evilmtv/CG3002-Dance-Dance-01/Docs/Handouts/Multi-Class Classification Tutorial with the Scikit-learn Library.pdf

# Multi‐Class Classification Tutorial with the Scikit‐learn Library

# Zhao Na

CG3002

# Overview

- Scikit‐learn is a Python library for machine learning that features various classification, regression and clustering algorithms including support vector machines, random forests, k‐means, and is designed to interoperate with the Python numerical and scientific libraries NumPy and SciPy.
- In this tutorial, you will discover how you can use Scikit‐learn to develop and evaluate SVM model for multi‐class classification problem.

# Problem Description

In this tutorial, we will use the standard machine learning dataset called the iris flowers dataset.

This dataset is well studied and is a good problem for practicing on machine learning because all of the 4 input variables are numeric and have the same scale in centimeters. Each instance describes the properties of an observed flower measurements and the output variable is specific iris species.

This is a multi
‐class classification problem, with three classes (flower species) to be predicted.

The iris flower dataset is a well
‐studied problem and a such we can expect to achieve a model accuracy in the range of 95% to 97%. This provides a good target to aim for when developing our models.

# Step‐by‐step tutorial

☐ Step 0: Data segmentation

☐ Step 1: Data pre‐processing

☐ Step 2: Model selection: choosing estimators and parameters

☐ Step 3: Evaluate the model with K‐fold cross validation

# Step 0: Data segmentation

In the iris flower dataset, there is no need to segment data. However, in your actual project data segmentation is necessary, because identifying the start and end of the actual activity from signals is important for recognizing the activity accurately.

There are several criteria to segment signal, such as:
- Time
- Abrupt change

# Step 0: Data segmentation

- In this tutorial, we give an example that how to segment signal with non‐overlap time window.

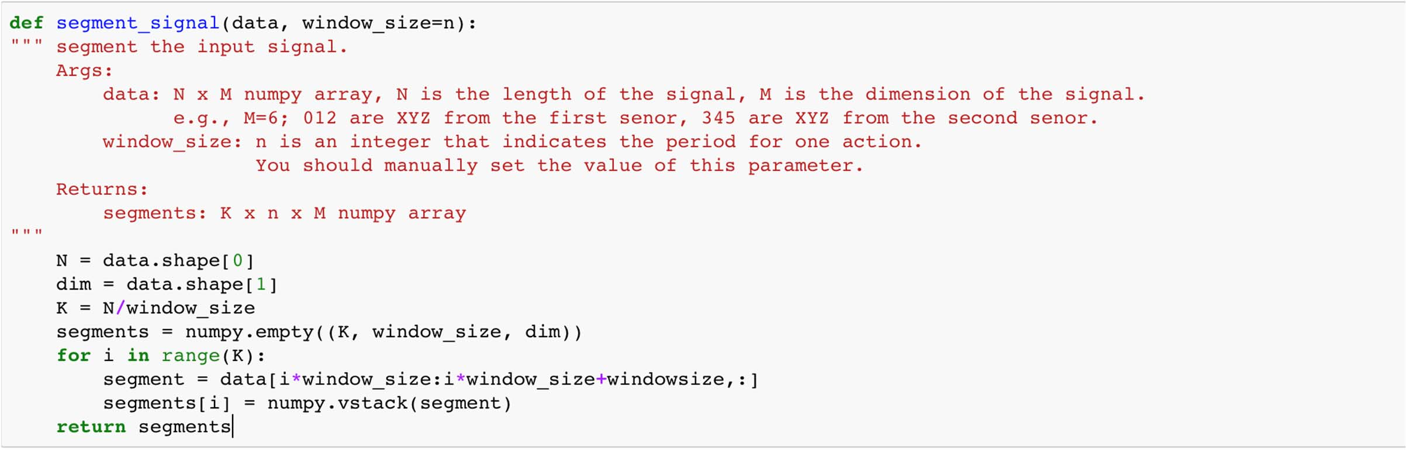
[picture p9: figure]

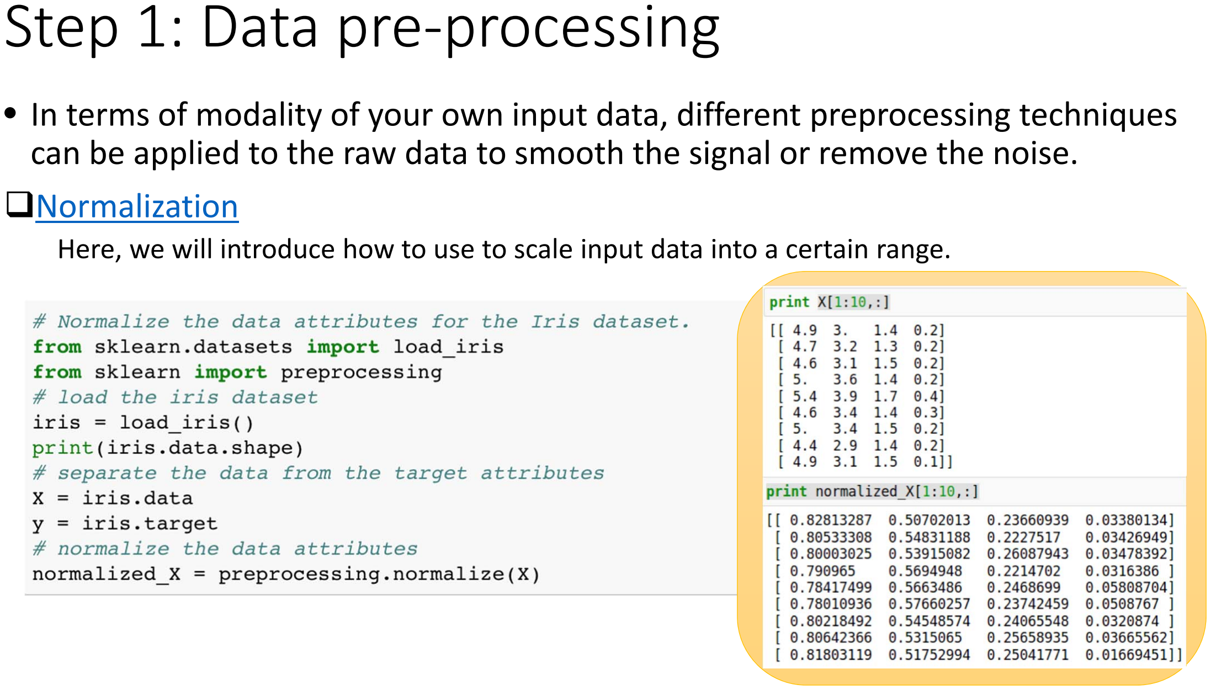
[picture p10: figure]
Step 1: Data pre‐processing; ☐Normalization

- In terms of modality of your own input data, different preprocessing techniques can be applied to the raw data to smooth the signal or remove the noise.

Here, we will introduce how to use to scale input data into a certain range.

# Step 1: Data pre‐processing

☐ Encode The Output Variable

In your project, the output variable contains 10 different string values, such as “jumping” and “busdriver”.
When modeling multi‐class classification problems, it is good practice to transform non‐ numerical labels to numerical labels.

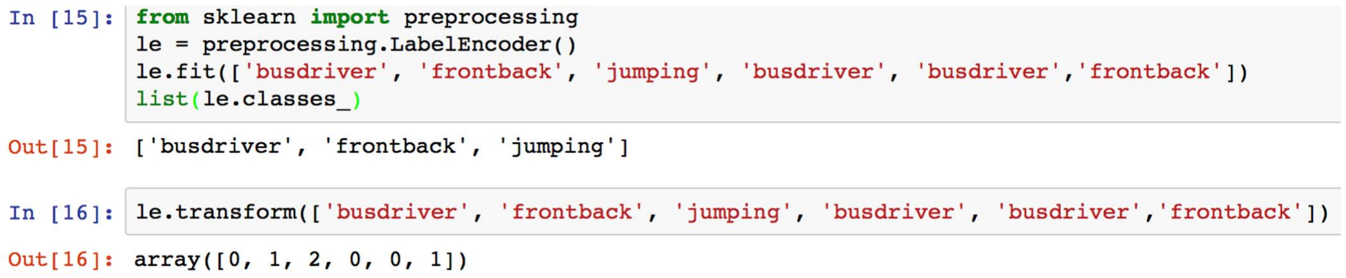
[picture p11: figure]

# Step 2: Model selection

- Here, we give an example of using SVM classifier. Also, you can select other models (such as Decision tree, KNN, and Neural network) to fit your data.

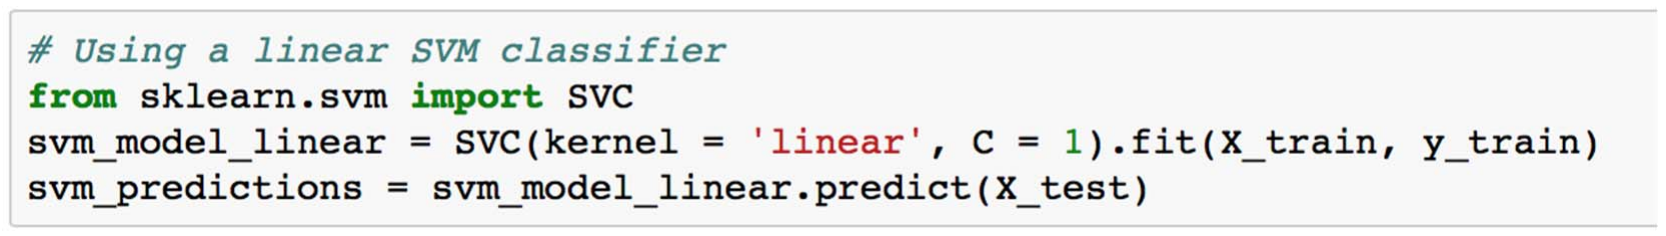
[picture p12: figure]

# Step 3: Evaluate the model

Evaluate the model with K‐fold cross validation
- We can now evaluate the SVM model on our training data.
- The scikit‐learn has excellent capability to evaluate models using a suite of techniques. The gold standard for evaluating machine learning models is k‐fold cross validation.

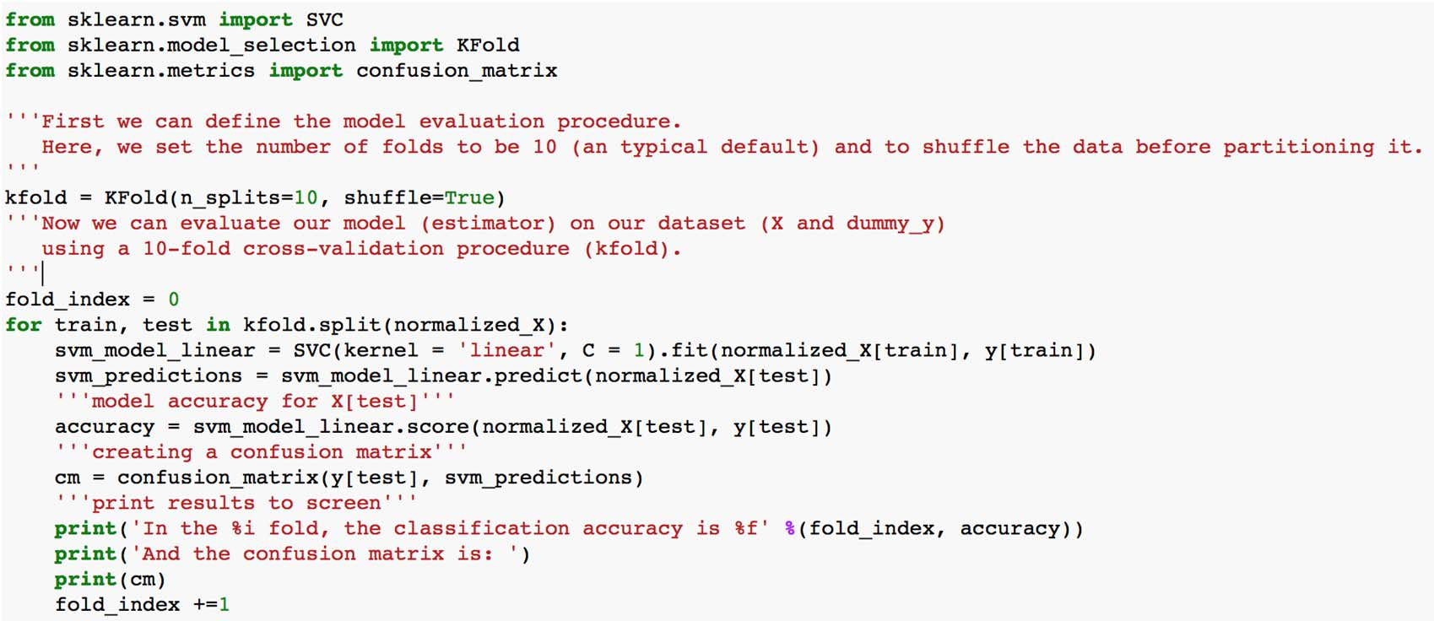
[picture p13: figure]

# Step 3: Evaluate the model

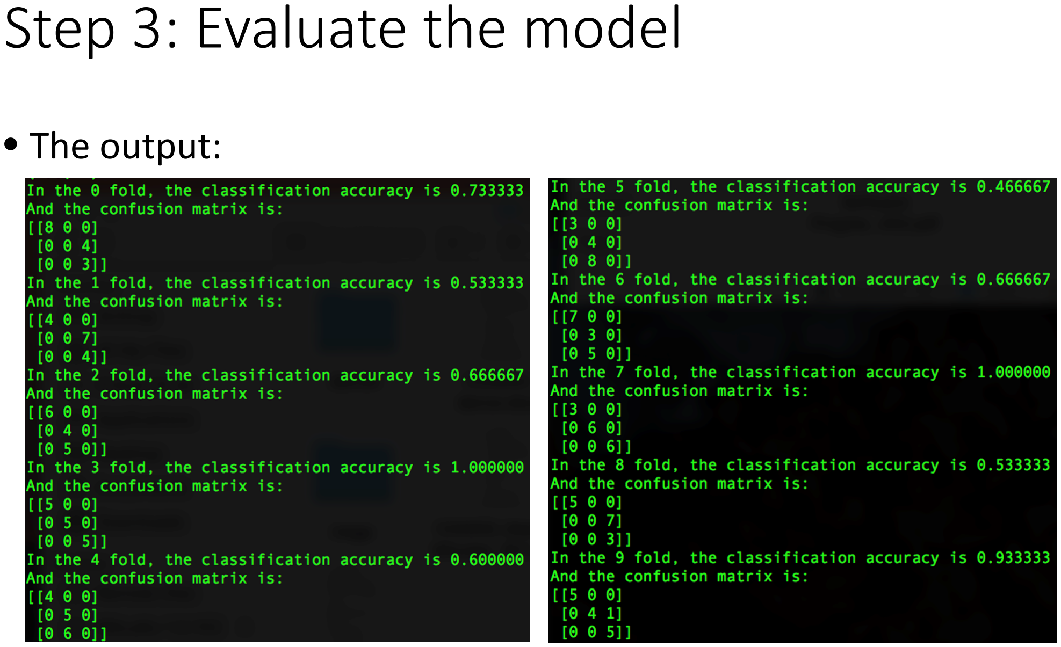
[picture p14: page 11]

- The output:
