evilmtv/CG3002-Dance-Dance-01/2 - Software/3 - Classification Models Test/dataset_SMALL.csv

user | gender | age | how_tall_in_meters | weight | body_mass_index | x1 | y1 | z1 | x2 | y2 | z2 | x3 | y3 | z3 | x4 | y4 | z4 | class
debora | Woman | 46 | 1,62 | 75 | 28,6 | -3 | 92 | -63 | -23 | 18 | -19 | 5 | 104 | -92 | -150 | -103 | -147 | sitting
debora | Woman | 46 | 1,62 | 75 | 28,6 | -3 | 94 | -64 | -21 | 18 | -18 | -14 | 104 | -90 | -149 | -104 | -145 | sitting
debora | Woman | 46 | 1,62 | 75 | 28,6 | -1 | 97 | -61 | -12 | 20 | -15 | -13 | 104 | -90 | -151 | -104 | -144 | sitting
debora | Woman | 46 | 1,62 | 75 | 28,6 | -2 | 96 | -57 | -15 | 21 | -16 | -13 | 104 | -89 | -153 | -103 | -142 | sitting
debora | Woman | 46 | 1,62 | 75 | 28,6 | -1 | 96 | -61 | -13 | 20 | -15 | -13 | 104 | -89 | -153 | -104 | -143 | sitting
debora | Woman | 46 | 1,62 | 75 | 28,6 | -2 | 95 | -62 | -14 | 19 | -16 | -13 | 104 | -89 | -153 | -104 | -142 | sitting
debora | Woman | 46 | 1,62 | 75 | 28,6 | 1 | 100 | -62 | -10 | 22 | -12 | -13 | 104 | -90 | -151 | -104 | -143 | sitting
debora | Woman | 46 | 1,62 | 75 | 28,6 | -1 | 97 | -63 | -13 | 20 | -15 | -12 | 104 | -88 | -151 | -104 | -142 | sitting
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
