evilmtv/CG3002-Dance-Dance-01/(commit log)

2017-10-31 Added timers
2017-10-31 Fixed minor error 18ms average!
    [software_and_firmware.py]
2017-10-31 Add files via upload
    Working 4 accelerometers at 115200 baud rate + checkSum edited
2017-11-01 Preprocessing data (nic and raph's data)
    [Raph0.csv, Raph1.csv, Raph2.csv, Raph3.csv, Raph4.csv, Raph5.csv, nic0.csv, nic1.csv]
2017-11-01 Update files
    [recorded_data.csv]
2017-11-01 Added more raw data
    [jun0.csv, jun1.csv, jun2.csv, jun3.csv, jun4.csv, jun5.csv, manish0.csv, manish1.csv]
2017-11-02 Improved code
    [log.csv]
2017-11-03 Organize Software files
    [Raph0.csv, Raph1.csv, Raph2.csv, Raph3.csv, Raph4.csv, Raph5.csv, dataset_SMALL.csv, jun0.csv]
2017-11-11 Added final_eval_server.py from IVLE
    Description: final_eval_server.py: This is the script we will use for the final test next week. I slightly modified the earlier sample_eval_server.py: 1) Fair choice of 40 moves (out of all 10 actions) so each action will be tested 4 times, at random order. 2) Server will wait for "logout" message from you after 40 moves Please test your system with this and let us know if there are problems!
2017-11-11 Update and reorganize files
    Rename folders
    Rename folders
    Rename Files
    [Raph0.csv, Raph1.csv, Raph2.csv, Raph3.csv, Raph4.csv, Raph5.csv, dataset_SMALL.csv, jun0.csv]
2017-11-11 Calibration functionality pseudo code
2017-11-12 Improved code speed and readability, Added calibration skeleton
    Rename file
2017-11-14 Attempt at fixing checksum, Added volt reading placeholder
2017-11-16 Fix server communications and added power readings
2017-11-16 Added raw data
    [r01.csv, r02.csv, r11.csv, r21.csv, r31.csv, r41.csv, r51.csv, r61.csv]
2017-11-16 Organize old files
    [Raph0.csv, Raph1.csv, Raph2.csv, Raph3.csv, Raph4.csv, Raph5.csv, jun0.csv, jun1.csv]
2017-11-16 Added code for cumulative power
2017-11-16 Archive old raw data
    [j01.csv, j02.csv, j11.csv, j21.csv, j31.csv, j41.csv, j51.csv, j61.csv]
2017-11-16 Changed to 50 sets of data per sample
2017-11-16 Added 3 sensor raw data
    [j0-1.csv, j0-2.csv, j3-1.csv, j4-1.csv, j6-1.csv, j7-1.csv, j8-1.csv, j9-1.csv]
2017-11-16 Updated code to use 3 sensors data
2017-11-19 Reorganized files
    [Raph0.csv, Raph1.csv, Raph2.csv, Raph3.csv, Raph4.csv, Raph5.csv, dataset_SMALL.csv, j0-1.csv]
